antopoid/Projet-frelons/Rapports_seances/kevin_DELLAPIAZZA.md

1er semestre

Séance du 27/08/21

-Récupération du dossier Git du groupe de l'année précédente
-Lecture et prise en main de l'ancien projet
-Visite des ruches sur le site polytech pour comprendre la problématique 
-récupération du matériel + définition des tâches à réaliser

Séance du 09/09/21

-Test des capteurs de tonalité sur site polytech au niveau des ruches
-Résultat pas concluant, Avec un enregistrement le module déclenche bien la présence d'un frelon 
mais lorsque l'on test en réel le module ne déclenche pas
-Nous supposons que le signal en entrée est trop faible par conséquent il va falloir les amplifier
-Vu que nous avons deux modules de détection:
	* sur la première, changement R2 470->220 Ohms pour augmenter le gain
	* sur la deuxième, changement du micro par un micro qui a un diamètre plus grand
	* sur les deux, changement des condensateurs C1 1µF -> 47µF 

Séance du 17/09/21

-Call fait avec Bernard Barrois et Jody Nourry sur le projet depuis longtemps afin de nous exposer 
leur problématique + explication du projet.
-Recherche des fréquences de détection (proche des 230Hz) rapport de test.
-Décision de mettre en suspent le détecteru de tonalité afin de créer une carte avec un esp32WROVER

Séance du 23/09/21

-Travaille de recherche sur les I/O et définitions de celles-ci (disponible ou non)
-Call sur un projet de détection d'image 

2ème semestre

Séance du 03/02/2022 

Recherche dans les datasheets afin de trouver et/ou de calculer les différentes consommations des sorties. 
Caméra : En action : 125mW 
	 En standby : P = U*I; Avec U=3.3V et I= 600µA Soit P= 3.3 * 600 E-6 = 1980 * 10-6

Séance du 10/02/2022 et du 11/02/2022

Objectif de la séance: faire fonctionner les différents systèmes
		       analyser le code pour la caméra (cf mail peter 06/02/2022)
Durant ces séances: analyse des différentes sources données dans le mail, j'ai essayé de comprendre les codes ce qui n'a pas était facile pour certains codes.

Séance du 03/03/2022 et du 04/03/2022

Objectif de la séance: analyser le code pour la caméra (cf mail peter 06/02/2022)
suite aux recherches faite les séances précédentes, je e suis attardé au répertoires du git données dans le mail avec le code pour la caméra:
Detecteur-ESP32-Cam-Blob-Detector/sketchbook/CaptureWithoutDelay_save3_6/CaptureWithoutDelay_save3_6.ino 
Dans un premier temps j'ai analysé l'ensemble du code afin de le comprendre et de savoir ce qui était fait.
puis dans un second temps, j'ai regardé fonction par fonction afin de les analyser une par une.
Le code permet de capturer les images issue de la caméra, dans le même temps de les analyser afin de voir les points les plus noirs sur la photo et de réagir en conséquence. 
une fois que les cliché ont était analyser selon la position de la tâche nous allons placer le laser afin de pointer l'endroit de l'image et d'actionner le laser. 

Séance du 11/03/2022
Présentation de la partie code caméra
Note suite à la présentation: rapport écrit pour la réalisation du code à transemettre au groupe
Continue les analyses du code et recherche sur les autres déposit fournie par Barrois

Séance du 29/03/2022

Objectif de la séance : rédaction du document descriptif de l'analyse des codes 

Le document, une fois finalisé, sera posté dans le fichier kevin_DELLAPIAZZA.

Durant cette séance j'ai également aidé pour testé la carte alimentation: 
	Nous avons dans un premier temps vérifier les 3V sur les PWM -> Validé
	Test V1: nous avons relevé 2.3 V pour 2.7 d'attendu
	Test V2: nous avons relevé 1.2V pour 1.8 attendu
