antopoid/Projet-frelons/Présentation_soutenance.pptx

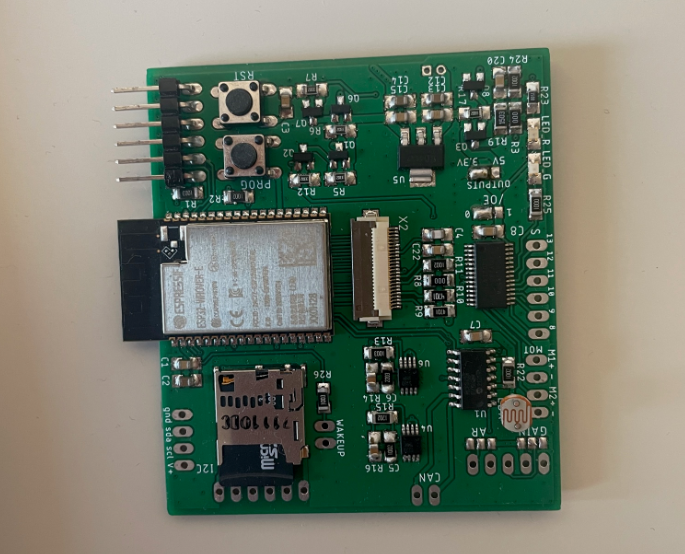
[picture p3: figure]

Projet Frelon
Soutenance finale

Lavenne, Kagbadouno, Delaunay, Poidevin, Dellapiazza

## Sommaire

- Rappel du projet
- Planning
- Test effectué sur la carte de test
- Test des fonctionnalités du PCBA
- La suite?

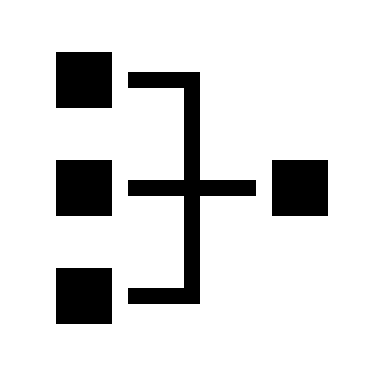
[picture p4: figure]
Schéma de réseau avec un remplissage uni

## Rappel du projet

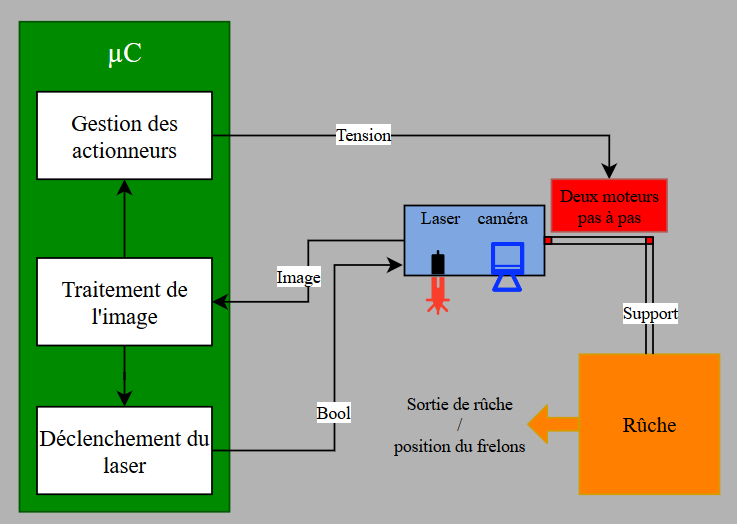
[picture p5: figure]

- Concevoir un système autonome pouvant protéger une ruche des frelons
- Utiliser un ESP32
- Trouver un moyen d’utiliser tous les périphériques malgré la contrainte sur les I/O

## Planning

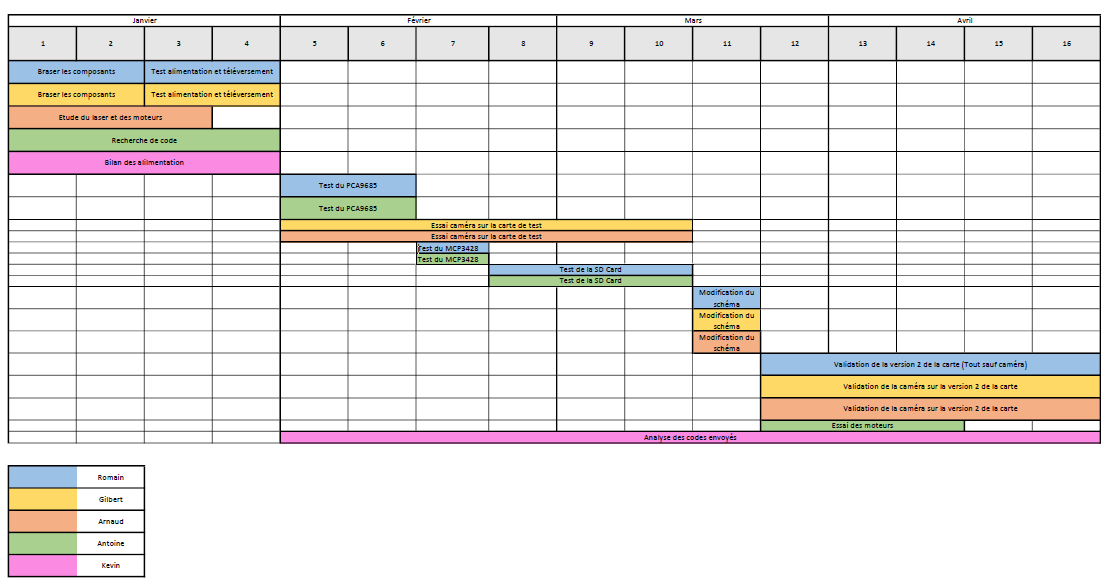
[picture p6: figure]

## Carte de test

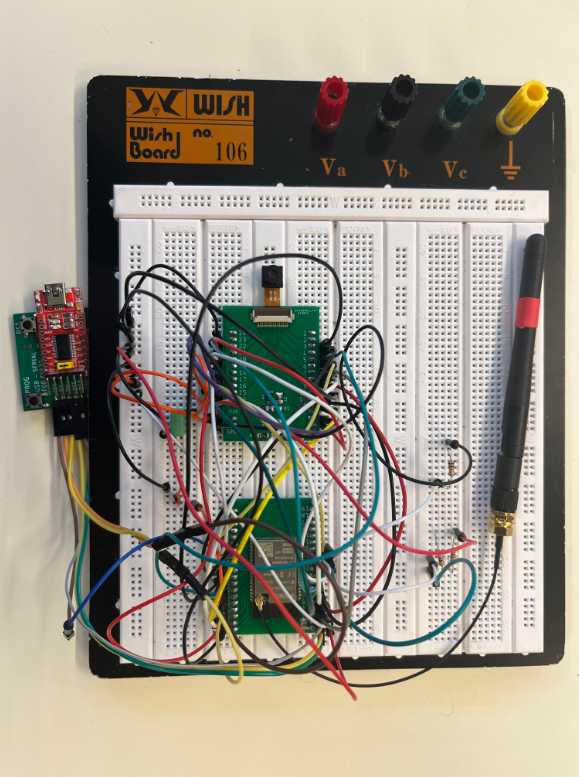
[picture p7: figure]

Carte de report caméra

Carte de report ESP32

- Vérifier les mêmes fonctionnalités en parallèle des essais sur le PCBA
- Faciliter le debug
- Trouver les anomalies
- Corriger et adapter le schéma final

## Carte de test

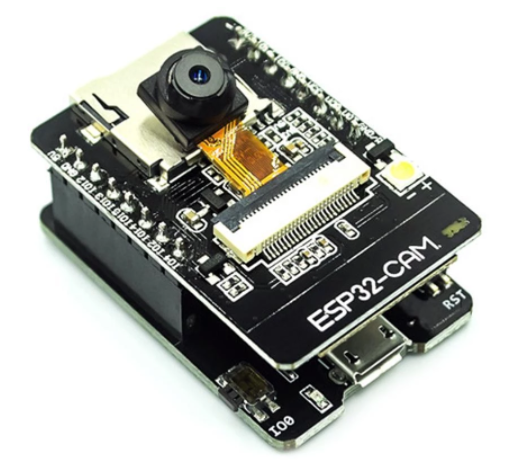
[picture p8: figure]

- Premiers essais sur un ESP32 CAM
- Valider un premier programme permettant de faire fonctioner la caméra

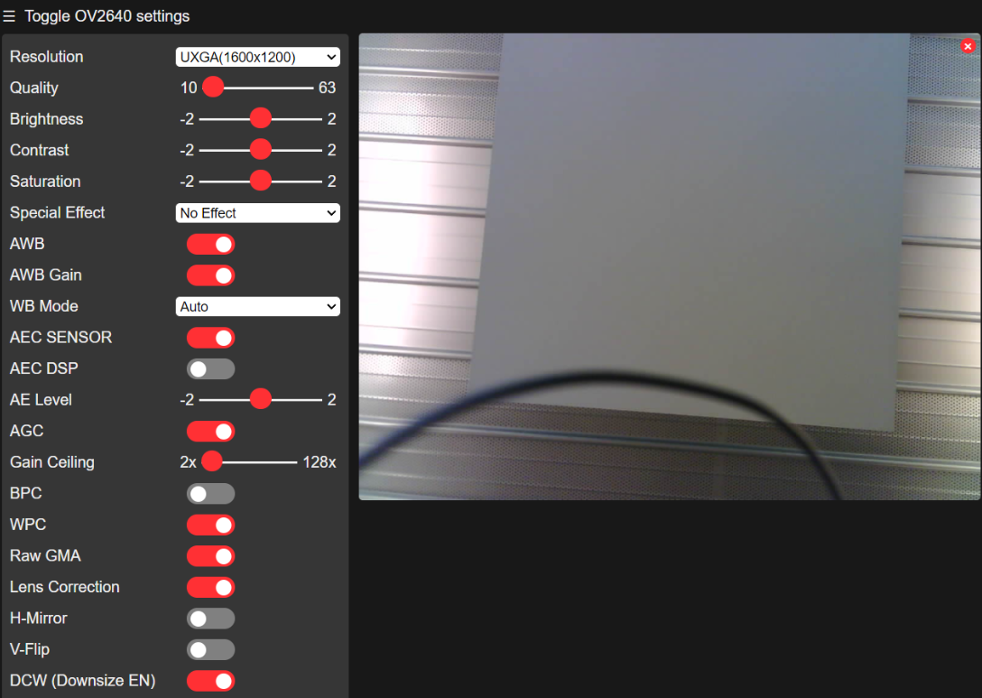
[picture p9: figure]

## Carte de test

Carte de report caméra

Carte de report ESP32

- Réutiliser le même code sur la carte de test
- Vérifier et adapter la correspondance des I/O
- Mesure des différents signaux d’alimentations

## Carte de test

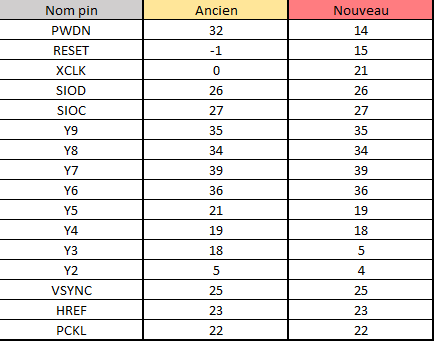
[picture p10: figure]

- Adaptation des pins

## Carte de test

Avant

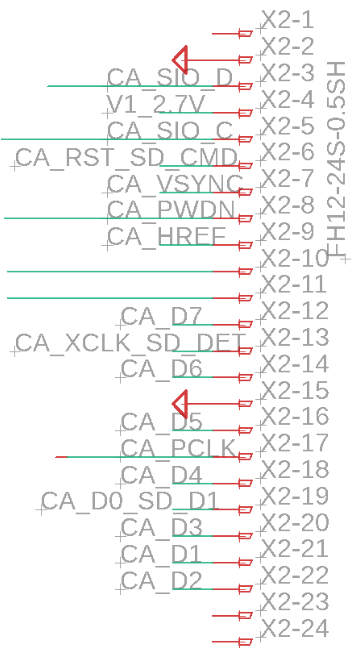
[picture p11: figure]

Après

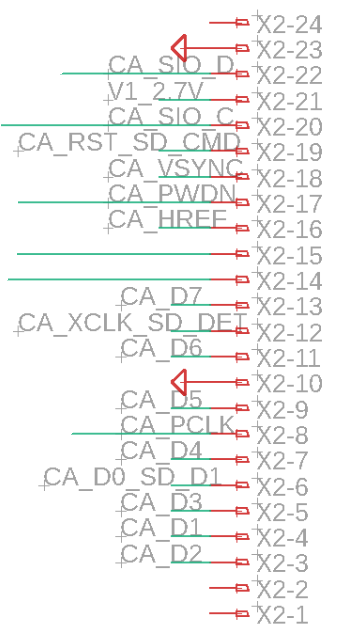
[picture p12: figure]

- Correspondance entre les pins et le bornier incorrect

## Test des fonctionnalités du PCBA

Micro

LDR

MCP3428

I2C

ESP32

I/O Caméra

Caméra

Spare

I/O Communes

Laser

PCA9685

SD Card

Alimentations

Moteurs

I/O SD Card

Leds

## Schéma du PCBA

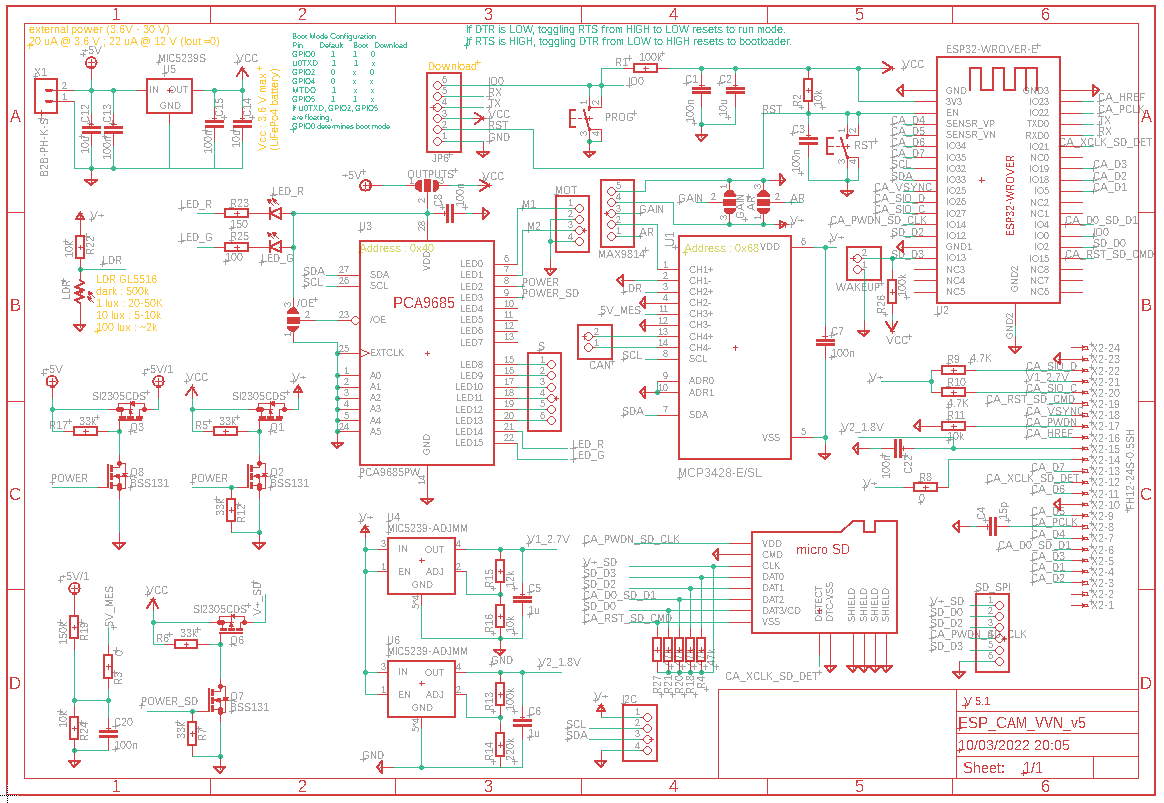
[picture p13: figure]

## Routage

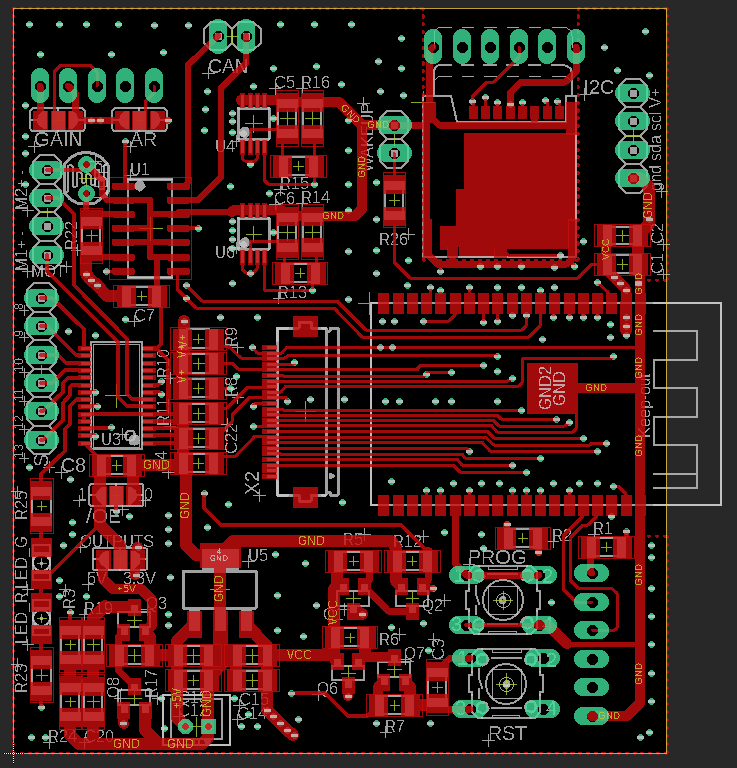
[picture p14: figure]
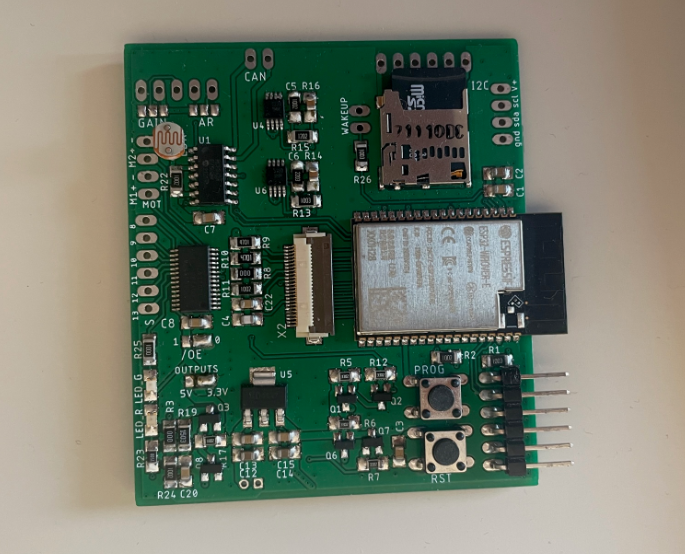
[picture p15: figure]

## Déroulement des tests

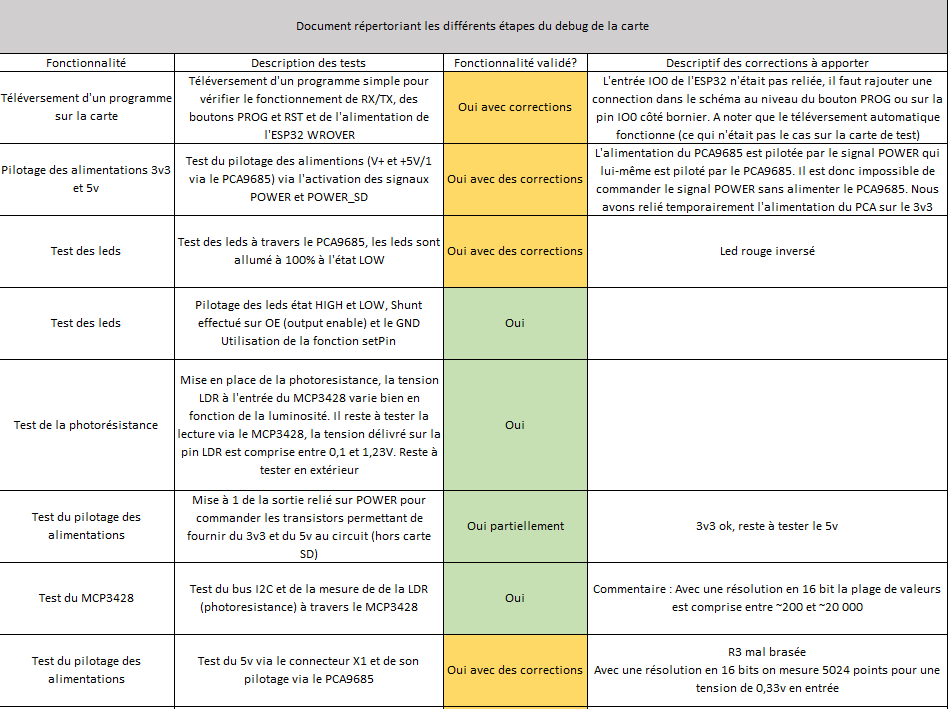
[picture p16: figure]

- Création d’un fichier de suivi
- Faciliter le debug de la carte et l’apport des corrections

## Alimentations et communication

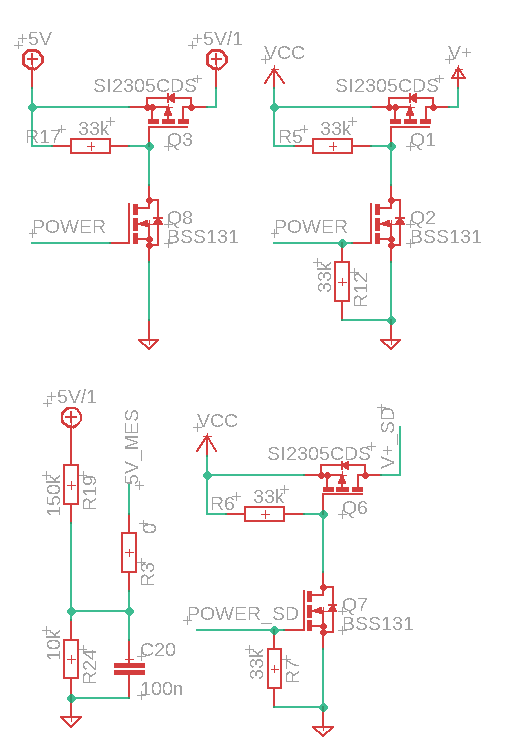
[picture p17: figure]

- I0 non connecté
- PCA9685 non alimenté en direct
- Pins I2C non standard

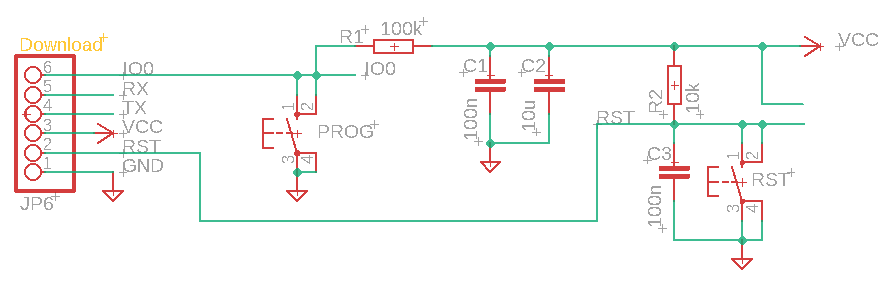
[picture p18: figure]

## PCA9685

Laser

Moteurs

Alimentations

PCA9685

Leds

- Test du pilotage des alimentations
- Faire clignoter simultanément les leds
- Faire tourner un moteur

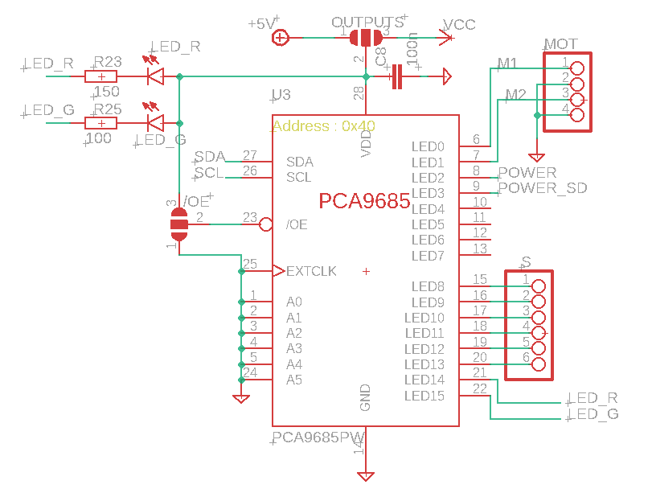
[picture p19: figure]

## MCP3428

Micro

LDR

Spare

MCP3428

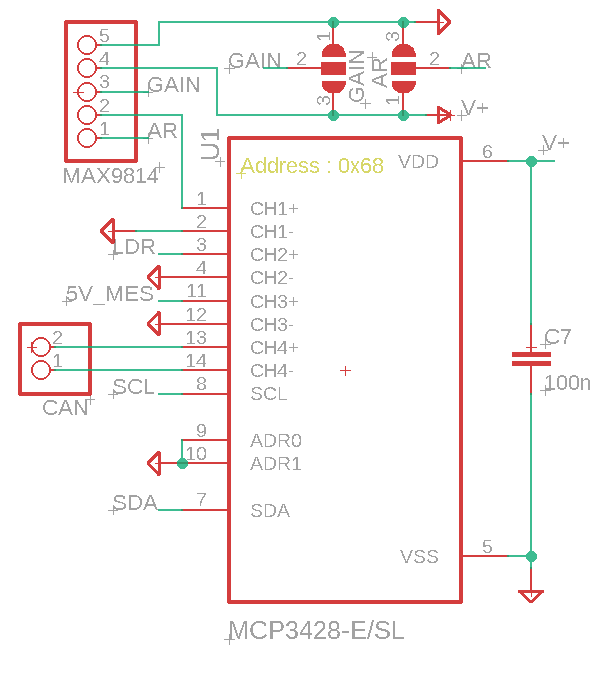
[picture p20: figure]

- Test de lecture de la valeur de la LDR sur 16 bits
- 0,1V - 1,23V ou 200 – 200 000 points
- Test de la mesure du 5V
- 0,33V – 5024 points

## SD Card

SD Card

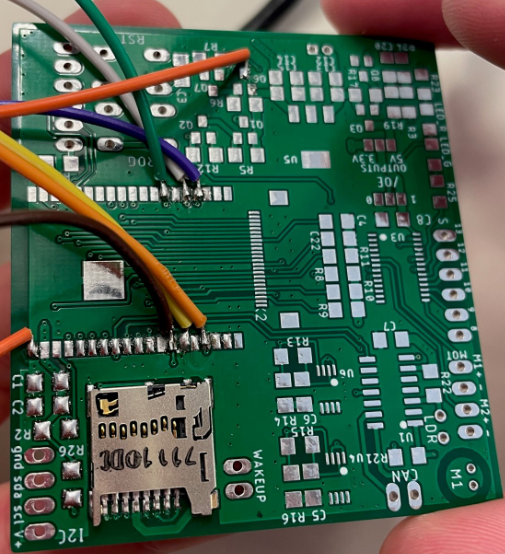
[picture p21: figure]

- Pins inversés
- Essai avec une carte de test et un ESP32 Lora concluant
- Test sur la version 2 de la carte, creation d’un fichier et d’un dossier

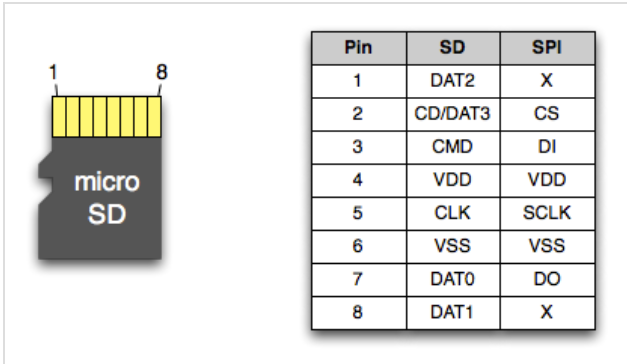
[picture p22: figure]

## Caméra

Caméra

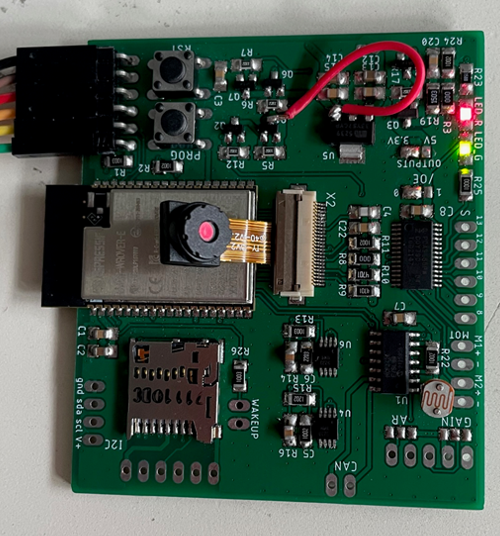
[picture p23: figure]

- Sérigraphie erronée
- Inversion C5/R16 et C6/R14
- Tensions pour la caméra correctes (1.8V, 2.7V, 3,3V)
- Caméra fonctionnelle (shunt alimentation)

## Analyse code Caméra

Caméra

Tirer avec le laser

Laser zone image

Réduction

Analyser cliché

Trouver frelon

Prendre cliché

Enregistrer cliché

## Bilan

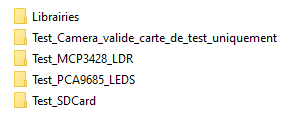
[picture p24: figure]

Programmes de test sur git

PCA9685

MCP3428

SD Card

Caméra

- Validé, verifier la partie pilotage des alimentations sur les nouveaux PCB

Validé, mais micro non testé

Validé, mais semble non fonctionnel avec une alimentation par USB

Validé
