antopoid/Projet-frelons/Dossier Antoine/Présentation Perso.pptx

## Présentation Personnelle Projet de ruche connectée

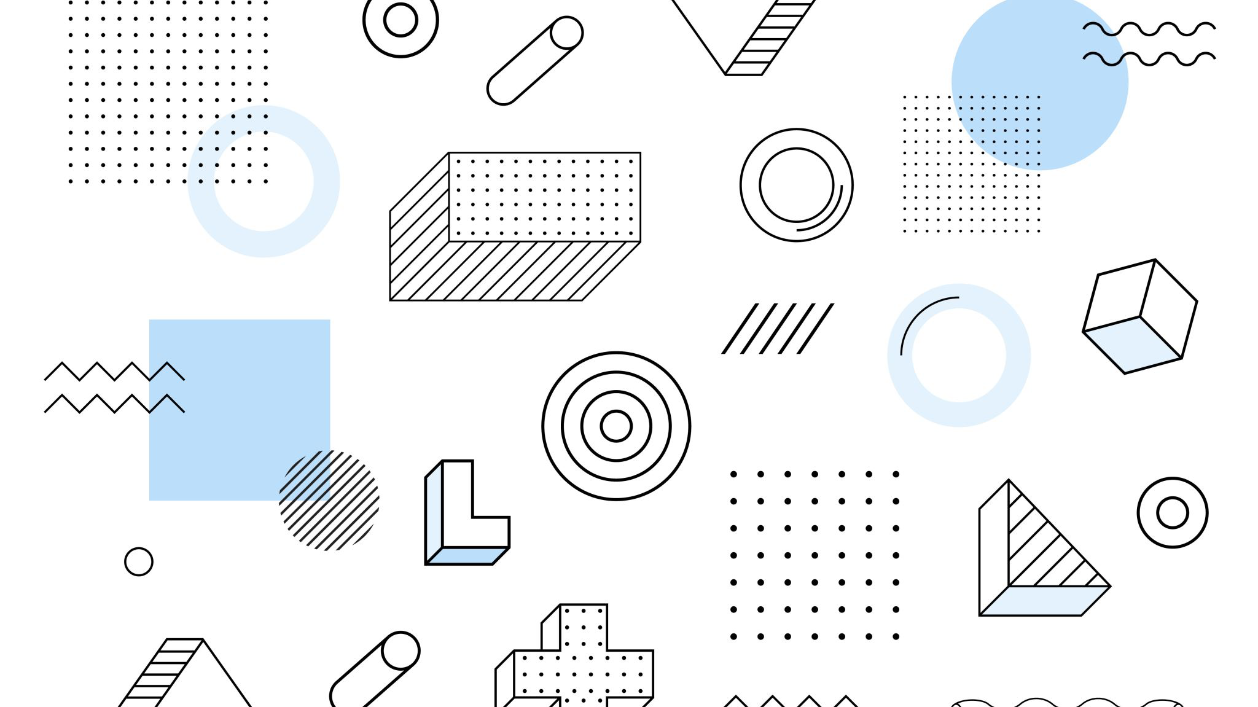
[picture p25: figure]
Représentation vectorielle moderne avec l’élément bleu

Antoine Poidevin
EII4
Polytech Nice Sophia

## Bref résumé des taches effectuées

- Création du git et explication au groupe
- Enregistrement et analyse du son des frelons
- Etudes du programmes de l’esp32-cam
- Test de l’esp32 soudé sur la carte de test
- Recherche de librairies adéquates pour notre montage
- Création d’un code fonctionnel
- Soudure, débogage, brasage, câblage.

## Création du git et explication au groupe

- https://github.com/antopoid/Projet-frelons
- Explications basiques sur le fonctionnement conventionnel de GIT
- Explications sur les commandes GIT à utiliser
- Création du GIT
- Création des répertoires et fichier de base sur le GIT

## Enregistrement et analyse du son des frelons

- Enregistrement de différents sons de frelons à cotés des ruches avec le groupe
- Analyse du son sur Audacity et décorticage du spectre en fréquence
- Test non concluant sur les différentes cartes

## Etudes du programmes de l’esp32-cam

- L’esp32-Cam de cher AiThinker possède une librairie dédié et un code servant d’exemple
- https:// (https://github.com/espressif/arduino-esp32/blob/master/libraries/ESP32/examples/Camera/CameraWebServer/CameraWebServer.ino)github.com (https://github.com/espressif/arduino-esp32/blob/master/libraries/ESP32/examples/Camera/CameraWebServer/CameraWebServer.ino)/ (https://github.com/espressif/arduino-esp32/blob/master/libraries/ESP32/examples/Camera/CameraWebServer/CameraWebServer.ino)espressif (https://github.com/espressif/arduino-esp32/blob/master/libraries/ESP32/examples/Camera/CameraWebServer/CameraWebServer.ino)/arduino-esp32/blob/master/ (https://github.com/espressif/arduino-esp32/blob/master/libraries/ESP32/examples/Camera/CameraWebServer/CameraWebServer.ino)libraries (https://github.com/espressif/arduino-esp32/blob/master/libraries/ESP32/examples/Camera/CameraWebServer/CameraWebServer.ino)/ESP32/ (https://github.com/espressif/arduino-esp32/blob/master/libraries/ESP32/examples/Camera/CameraWebServer/CameraWebServer.ino)examples (https://github.com/espressif/arduino-esp32/blob/master/libraries/ESP32/examples/Camera/CameraWebServer/CameraWebServer.ino)/Camera/ (https://github.com/espressif/arduino-esp32/blob/master/libraries/ESP32/examples/Camera/CameraWebServer/CameraWebServer.ino)CameraWebServer (https://github.com/espressif/arduino-esp32/blob/master/libraries/ESP32/examples/Camera/CameraWebServer/CameraWebServer.ino)/ (https://github.com/espressif/arduino-esp32/blob/master/libraries/ESP32/examples/Camera/CameraWebServer/CameraWebServer.ino)CameraWebServer.ino (https://github.com/espressif/arduino-esp32/blob/master/libraries/ESP32/examples/Camera/CameraWebServer/CameraWebServer.ino)
- C’est un serveur web connecté en wifi faisant un Stream vidéo de la camera embarqué
- L’image est traitée et analysée par l’appareil se connectant sur la page web local
- Apres avoir étudié ce code il nous servira par la suite pour tester

## Test de l’esp32 soudé sur la carte de test

- Brasage de l’esp32 dans un four avec le groupe
- Branchement de l’esp32 avec le petit module USB-serie
- Vérification des tensions obtenues
- Création d’un code basique ou l’on communique avec le port série
- Teléversement et validation du fonctionnement

## Recherche de librairies adéquates pour notre montage

- Il nous fallait des librairies pour tester le fonctionnement du :
- PCA9685
- MCP3428
- Camera
- Carte SD
Recherche de librairies bien spécifique permettant de changer les ports dédié au fonctionnement de chaque modules

## Création d’un code fonctionnel
