antopoid/Projet-frelons/Tuto-ESP32Cam.pdf

# C'est quoi une ESP32-Cam ?Comment la programmer ?

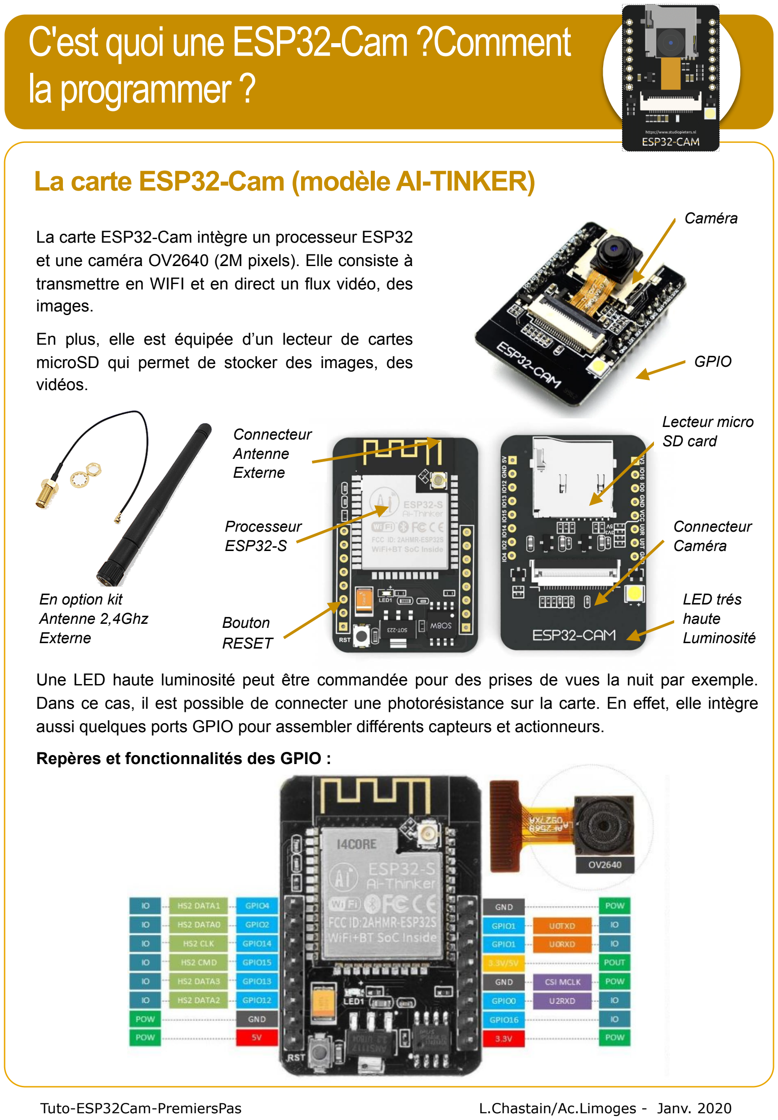
[picture p26: page 1]

Tuto-ESP32Cam-PremiersPas | L.Chastain/Ac.Limoges - Janv. 2020

La carte ESP32-Cam intègre un processeur ESP32 et une caméra OV2640 (2M pixels). Elle consiste à transmettre en WIFI et en direct un flux vidéo, des images.

En plus, elle est équipée d’un lecteur de cartes microSD qui permet de stocker des images, des vidéos.

## La carte ESP32-Cam (modèle AI-TINKER)

Caméra

Connecteur
Antenne
Externe

En option kit
Antenne 2,4Ghz
Externe

Processeur
ESP32-S

Bouton
RESET

Lecteur micro
SD card

Connecteur
Caméra

LED trés
haute
Luminosité

Une LED haute luminosité peut être commandée pour des prises de vues la nuit par exemple. Dans ce cas, il est possible de connecter une photorésistance sur la carte. En effet, elle intègre aussi quelques ports GPIO pour assembler différents capteurs et actionneurs.
Repères et fonctionnalités des GPIO :

GPIO

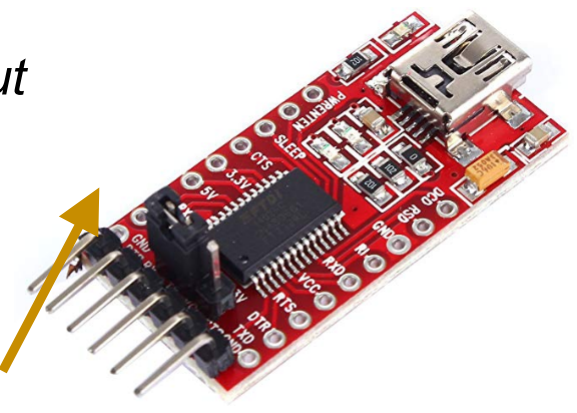
[picture p27: figure]
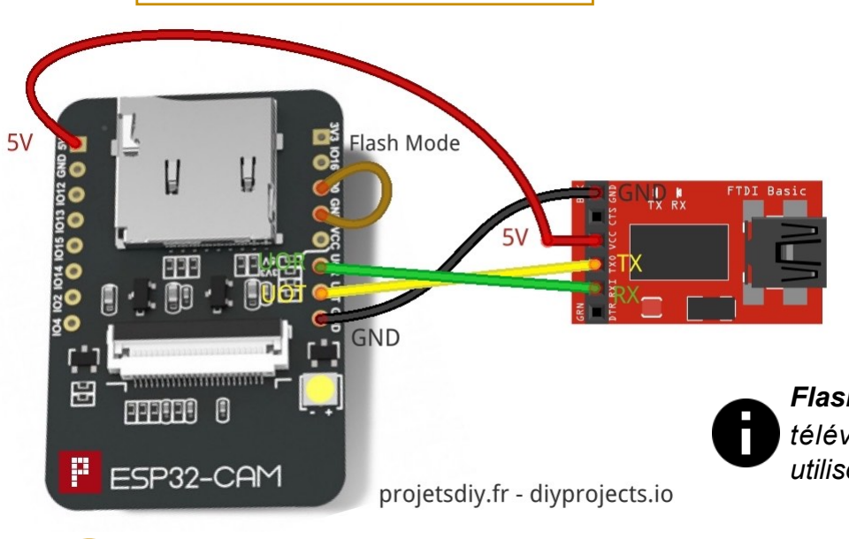
[picture p28: figure]
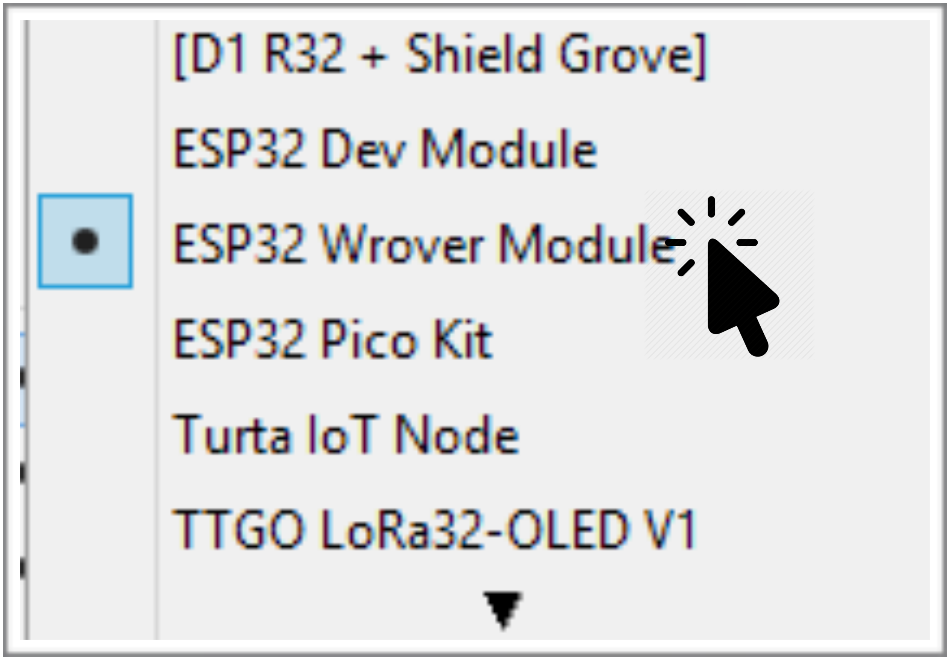
[picture p29: figure]

Tuto-ESP32Cam-PremiersPas | L.Chastain/Ac.Limoges - Janv. 2020

Il s’agit de charger le serveur vidéo web dans la carte. Le programme est mis à disposition dans la version d’Arduino Augmenté de chez DUINOEDU qui intègre la bibliothèque adéquate.

Réaliser le câblage et
connecter le FTDI au PC

1

## Programmer la carte ESP32-Cam(AI-Tinker)

Pour téléverser tout programme dans la carte ESP32-Cam, il faut utiliser un module électronique appelé FTDI232.

Cavalier sur 5V

ESP32Cam | FTDI
GND | GND
5V | VCC
U0R | TX
U0T | RX
GPIO0 | GND

Flash Mode : relier GPI0 au GND lors du téléversement. Retirer le câble pour utiliser la ESP32cam.

Lancer l'IDE Arduino
Augmenté

2

Aller dans Outils-->Gestionnaire de c a r t e s - - > S é l e c t i o n n e r ESP32WroverModule

3

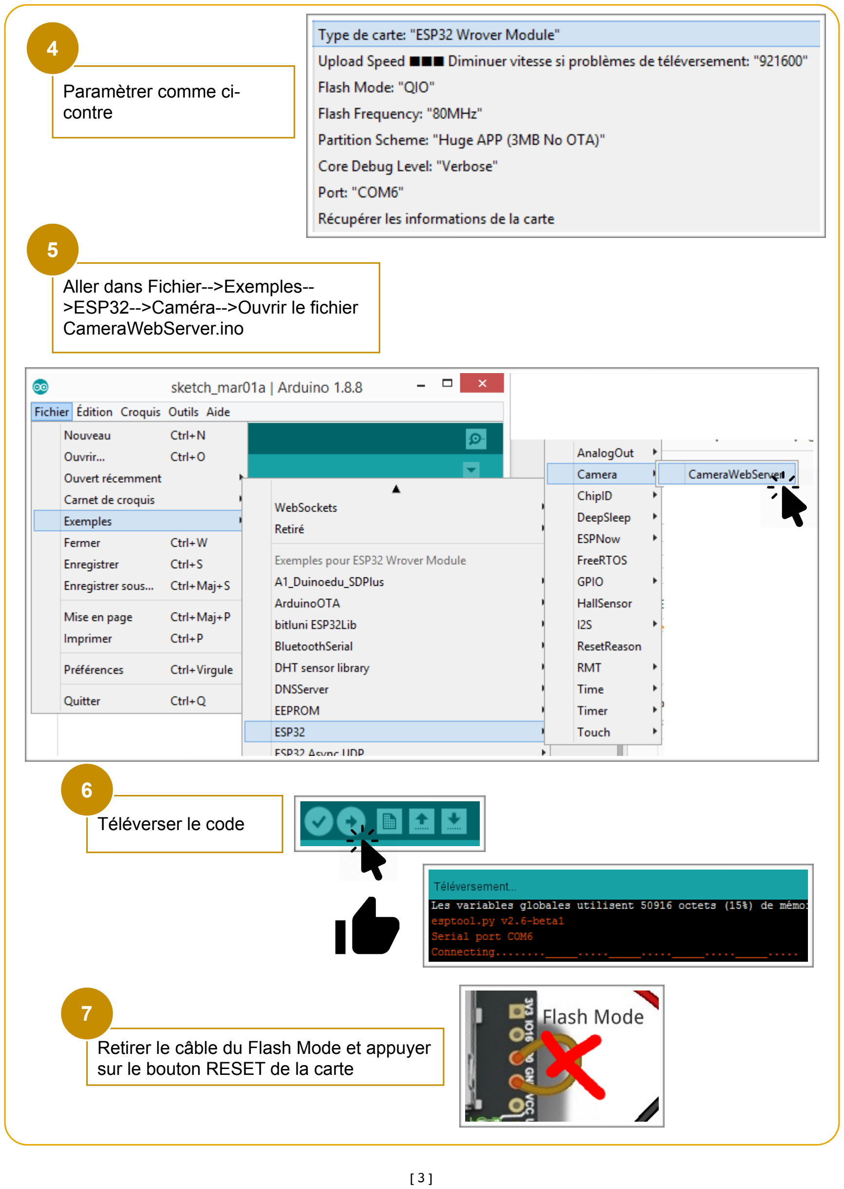
[picture p30: page 3]

[3]

Aller dans Fichier-->Exemples-->ESP32-->Caméra-->Ouvrir le fichier CameraWebServer.ino

5

Paramètrer comme ci-contre

4

Téléverser le code

6

Retirer le câble du Flash Mode et appuyer sur le bouton RESET de la carte

7

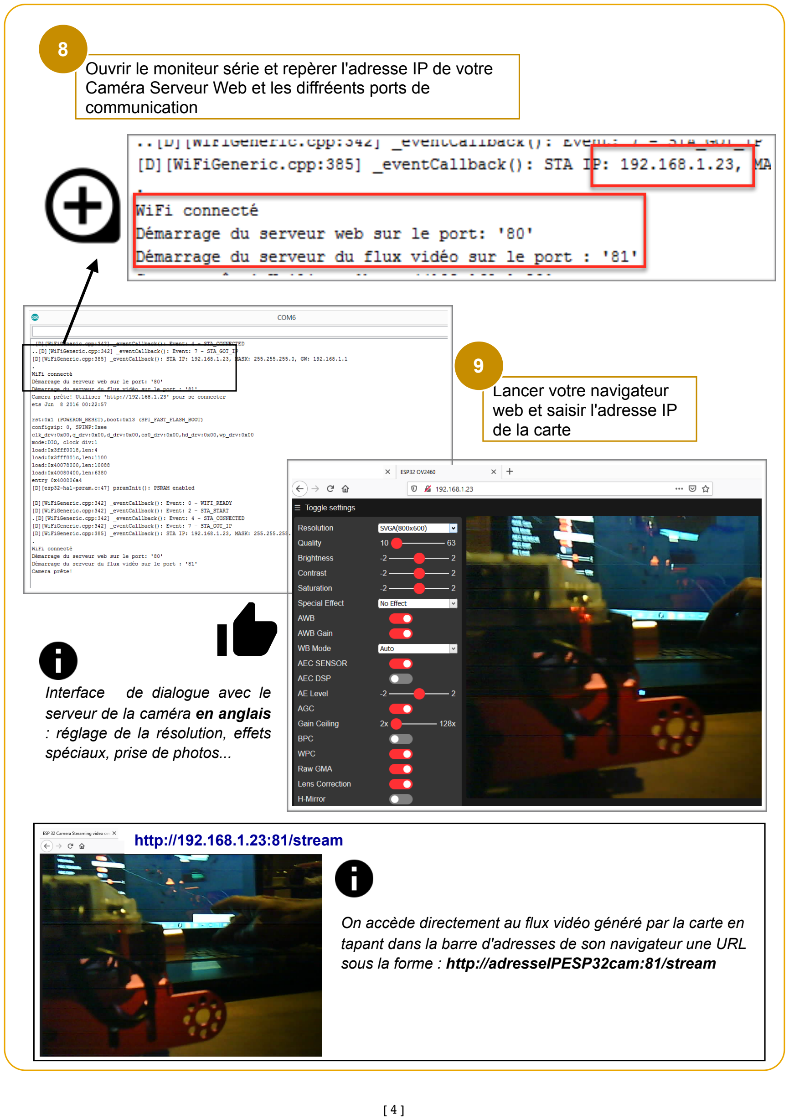
[picture p31: page 4]

[4]

Ouvrir le moniteur série et repèrer l'adresse IP de votre Caméra Serveur Web et les diffréents ports de communication

8

Lancer votre navigateur
web et saisir l'adresse IP de la carte

9

Interface de dialogue avec le serveur de la caméra en anglais : réglage de la résolution, effets spéciaux, prise de photos...

On accède directement au flux vidéo généré par la carte en tapant dans la barre d'adresses de son navigateur une URL sous la forme : http://adresseIPESP32cam:81/streamhttp://192.168.1.23:81/stream
