antopoid/Projet-frelons/Gantt.pdf

Test du MCP3428
Test du MCP3428

Modification du
schéma
| Modification du schéma
| | Validation de la version 2 de la carte (Tout sauf caméra)
| | Validation de la caméra sur la version 2 de la carte
| | Validation de la caméra sur la version 2 de la carte
| | Essai des moteurs
Analyse des codes envoyés

Romain

Gilbert

Arnaud

Antoine

Kevin

Test de la SD Card
Test de la SD Card
| Modification du schéma

Essai caméra sur la carte de test

Janvier | Février | Mars | Avril
1 | 2 | 3 | 4 | 5 | 6 | 7 | 8 | 9 | 10 | 11 | 12 | 13 | 14 | 15 | 16
Braser les composants | | Test alimentation et téléversement
Braser les composants | | Test alimentation et téléversement

Etude du laser et des moteurs

Recherche de code

Bilan des alilmentation

| | | | Test du PCA9685
| | | | Test du PCA9685
| | | | Essai caméra sur la carte de test

#Internal
