antopoid/Projet-frelons/Dossier Romain/1.jpg

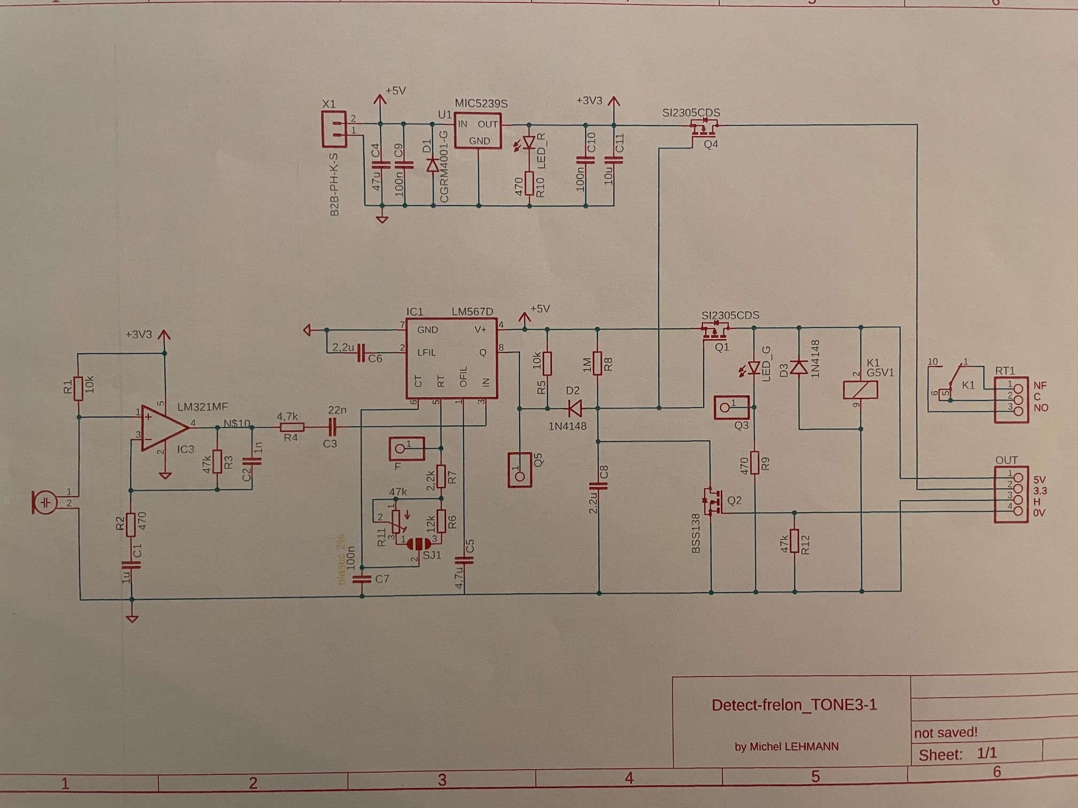
Dossier Romain/1.jpg
