antopoid/Projet-frelons/Dossier Romain/2.jpg

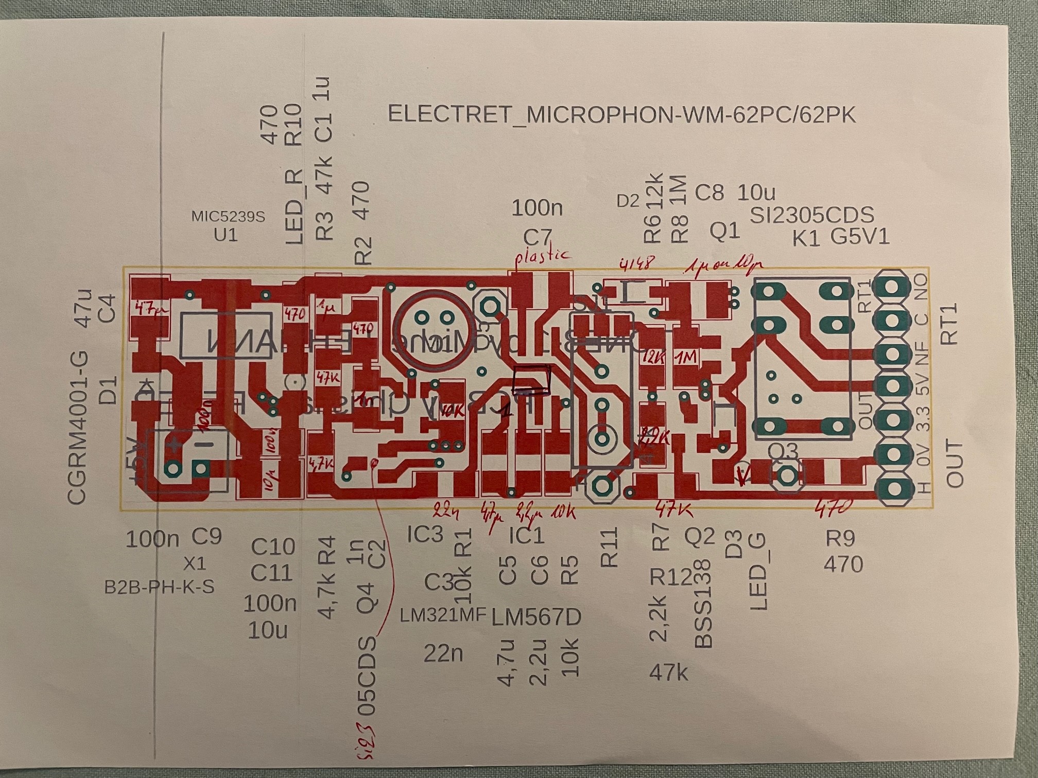
Dossier Romain/2.jpg
