antopoid/Projet-frelons/Ancien Projet/Rapport de fabrication/READ ME.md

## Bzz_final : 
projet arduino à téleverser sur l'ESP32-CAM.

  A faire : 
*    Réception message de détection sonore d'un frelon par l'Arduino (UART)
*    Tests

## fft_detection : 
projet arduino à téleverser sur l'Arduino Micro.
  
  A faire : 
*    Envoi du message de détection sonore d'un frelon par L'Arduino (UART)

## calculateur_composant_buck : 
Calcule les valeurs des composants utilisés pour le circuit qui pilote le laser

## Ruche_V1.0
Cartes électroniques sous Kicad ainsi que les bibliothèques des composants nécessaires.

  A faire :
*    Ajouter la photorésistance
*    Ajouter le régulateur Boost +12V
*    Faire la BOM (Bills Of Materials)
*    Rooter le PCB (Printed Circuit Board)
