antopoid/Projet-frelons/(list of files, drawings)

Other design files:
ExecutablePourTest/Librairies/MFRC522/doc/fritzing/Arduino-Uno-r3-with-RFID-RC522.fzz
