antopoid/Projet-frelons/Ancien Projet/Dossier Lucas/Ruche_V1.0/Projet_ruche_V1.0/Projet_ruche_V1.0.kicad_pcb

## KiCad design PRO-BOX.kicad_sch

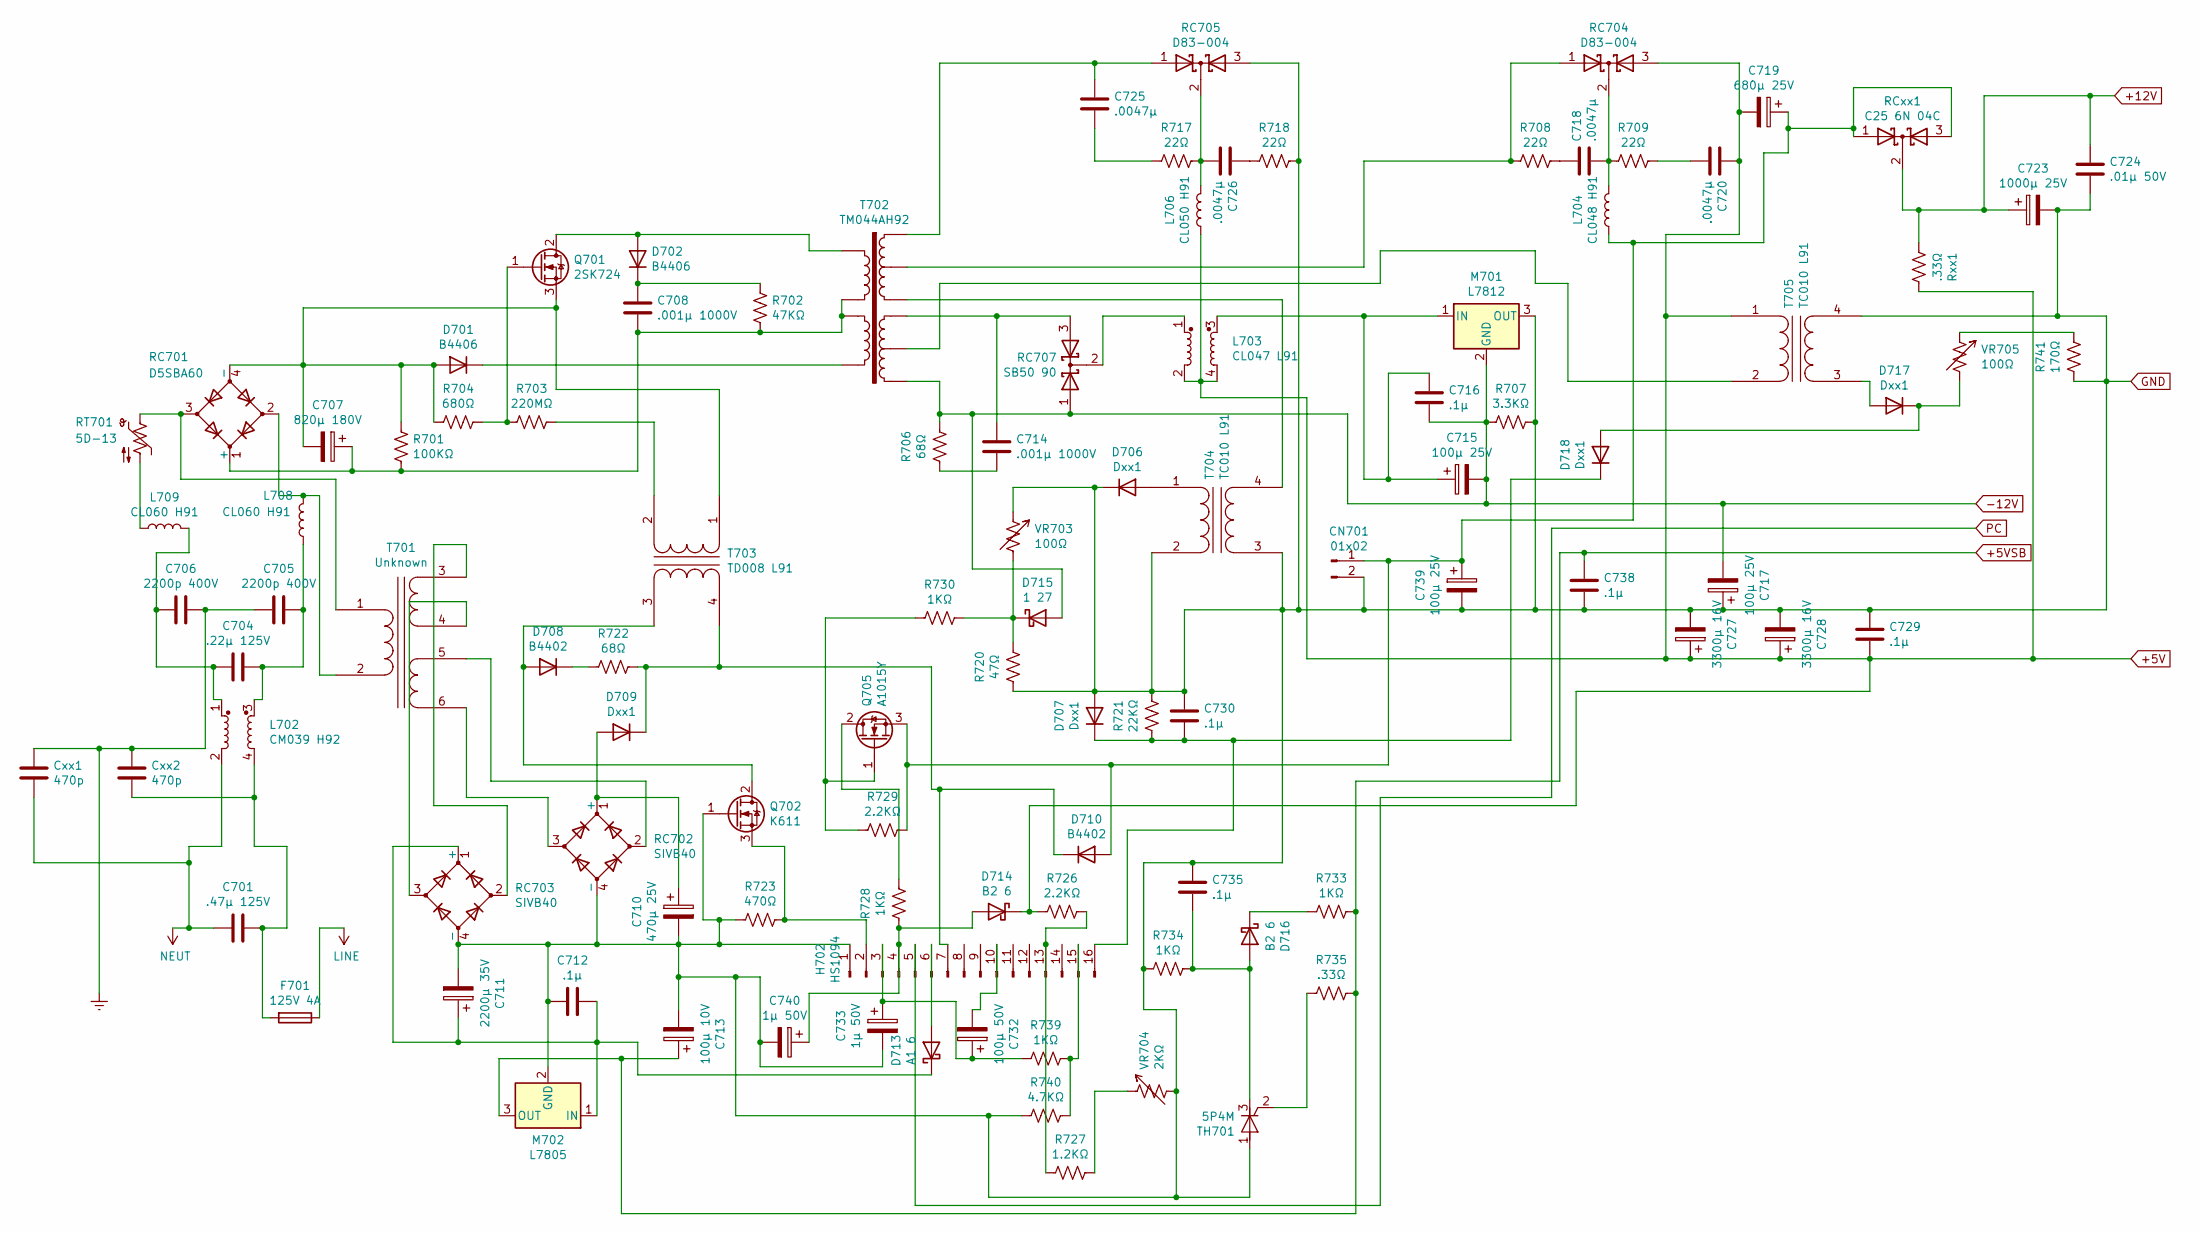
[picture p81: schematic PRO-BOX.kicad_sch]

Parts:
C701: .47μ 125V
C704: .22μ 125V
C705, C706: 2200p 400V
C707: 820μ 180V
C708, C714: .001μ 1000V
C710: 470μ 25V
C711: 2200μ 35V
C712, C716, C729, C730, C735, C738: .1μ
C713: 100μ 10V
C715, C717, C739: 100μ 25V
C718, C720, C725, C726: .0047μ
C719: 680μ 25V
C723: 1000μ 25V
C724: .01μ 50V
C727, C728: 3300μ 16V
C732: 100μ 50V
C733, C740: 1μ 50V
CN701: 01x02
Cxx1, Cxx2: 470p
D701, D702: B4406
D706, D707, D709, D717, D718: Dxx1
D708, D710: B4402
D713: A1 6
D714, D716: B2 6
D715: 1 27
F701: 125V 4A
H702: HS1094
L702: CM039 H92
L703: CL047 L91
L704: CL048 H91
L706: CL050 H91
L708, L709: CL060 H91
M701: L7812
M702: L7805
Q701: 2SK724; TO-220-3_Vertical
Q702: K611; TO-220-3_Vertical
Q705: A1015Y; TO-220-3_Vertical
R701: 100KΩ
R702: 47KΩ
R703: 220MΩ
R704: 680Ω
R706, R722: 68Ω
R707: 3.3KΩ
R708, R709, R717, R718: 22Ω
R720: 47Ω
R721: 22KΩ
R723: 470Ω
R726, R729: 2.2KΩ
R727: 1.2KΩ
R728, R730, R733, R734, R739: 1KΩ
R735: .33Ω
R740: 4.7KΩ
R741: 170Ω
RC701: D5SBA60
RC702, RC703: SIVB40
RC704, RC705: D83-004
RC707: SB50 90
RCxx1: C25 6N 04C
RT701: 5D-13
Rxx1: .33Ω
T701: Unknown
T702: TM044AH92
T703: TD008 L91
T704, T705: TC010 L91
TH701: 5P4M; TO-92_Inline
VR703, VR705: 100Ω
VR704: 2KΩ

Connections:
+5V: C719.2, C720.1, C727.1, C728.1, C729.2, D714.1 (K), L703.2, L703.4, L706.1, R726.1, RC704.3 (A), Rxx1.2, T705.1 (AA)
+5VSB: C713.1, C738.1, M702.3 (OUT), R733.2, R735.2
+12V: C723.1, C724.1, RCxx1.2 (K), Rxx1.1
-12V: C715.2, C716.2, C717.2, D715.2 (A), M701.2 (GND), R706.2, R707.1, RC707.1 (A), T702.5
GND: C710.2, C711.2, C712.2, C713.2, C717.1, C723.2, C724.2, C727.2, C728.2, C729.1, C730.1, C733.2, C735.1, C738.2, C739.2, C740.2, CN701.2, D706.1 (K), D707.2 (A), H702.1, M701.3 (OUT), M702.2 (GND), Q702.1 (G), R707.2, R718.2, R720.1, R721.2, R723.1, R734.1, R740.1, R741.1, RC702.4 (-), RC703.4 (-), RC705.3 (A), T704.2 (AB), T704.3 (SA), T705.4 (SB), TH701.1 (A), VR703.1, VR704.2
unnamed: C701.1, Cxx2.2, F701.2, L702.4
unnamed: C701.2, Cxx1.2, L702.2
unnamed: C704.1, C705.1, L702.3, L708.2
unnamed: C704.2, C706.2, L702.1, L709.2
unnamed: C705.2, C706.1, Cxx1.1, Cxx2.1
unnamed: C707.1, C708.2, R701.2, R702.2, RC701.1 (+), T702.2, T702.3
unnamed: C707.2, D701.2 (A), Q701.3 (S), R701.1, R704.2, RC701.4 (-), T703.1 (AA)
unnamed: C708.1, D702.1 (K), R702.1
unnamed: C710.1, D709.2 (A), RC702.1 (+)
unnamed: C711.1, C712.1, D713.1 (K), M702.1 (IN), RC703.1 (+)
unnamed: C714.1, RC707.3 (A), T702.7
unnamed: C714.2, R706.1
unnamed: C715.1, C716.1, L703.3, M701.1 (IN)
unnamed: C718.1, R708.2
unnamed: C718.2, L704.2, R709.1, RC704.2 (K)
unnamed: C719.1, C739.1, CN701.1, D710.2 (A), L704.1, Q705.3 (S), R729.2, RCxx1.1 (A), RCxx1.3 (A)
unnamed: C720.2, R709.2
unnamed: C725.1, RC705.1 (A), T702.10
unnamed: C725.2, R717.1
unnamed: C726.1, R718.1
unnamed: C726.2, L706.2, R717.2, RC705.2 (K)
unnamed: C730.2, D707.1 (K), D718.1 (K), H702.16, R721.1
unnamed: C732.1, C733.1, H702.3, R739.1
unnamed: C732.2, H702.10
unnamed: C735.2, D716.2 (A), R734.2, TH701.3 (K)
unnamed: C740.1, D714.2 (A), H702.4, R728.1
unnamed: D701.1 (K), T702.4
unnamed: D702.2 (A), Q701.2 (D), T702.1
unnamed: D706.2 (A), T704.1 (AA)
unnamed: D708.1 (K), R722.1
unnamed: D708.2 (A), Q702.2 (D), T703.3 (SA)
unnamed: D709.1 (K), D710.1 (K), H702.7, R722.2, T703.4 (SB)
unnamed: D713.2 (A), H702.6
unnamed: D715.1 (K), R720.2, R730.2, VR703.2
unnamed: D716.1 (K), R733.1
unnamed: D717.1 (K), D718.2 (A), VR705.2
unnamed: D717.2 (A), T705.3 (SA)
unnamed: H702.2, Q702.3 (S), R723.2
unnamed: H702.13, R726.2, R727.1
unnamed: H702.15, R739.2, R740.2
unnamed: L703.1, RC707.2 (K)
unnamed: L708.1, RC701.2, T701.2 (AB)
unnamed: L709.1, RT701.2
unnamed: Q701.1 (G), R703.2, R704.1
unnamed: Q705.1 (G), R729.1, R730.1
unnamed: Q705.2 (D), R728.2
unnamed: R703.1, T703.2 (AB)
unnamed: R708.1, RC704.1 (A), T702.9
unnamed: R727.2, VR704.1
unnamed: R735.1, TH701.2 (G)
unnamed: R741.2, VR705.1
unnamed: RC701.3, RT701.1, T701.1 (AA)
unnamed: RC702.2, T701.5 (SC)
unnamed: RC702.3, T701.6 (SD)
unnamed: RC703.2, T701.3 (SA)
unnamed: RC703.3, T701.4 (SB)
unnamed: T702.6, T705.2 (AB)
unnamed: T702.8, T704.4 (SB)
PC: H702.5
