antopoid/Projet-frelons/Schema_carte/Essais/ESP_CAM_VVN_v4.brd

## EAGLE design Schema_carte/Essais/ESP_CAM_VVN_v4.brd (2022-03-04)

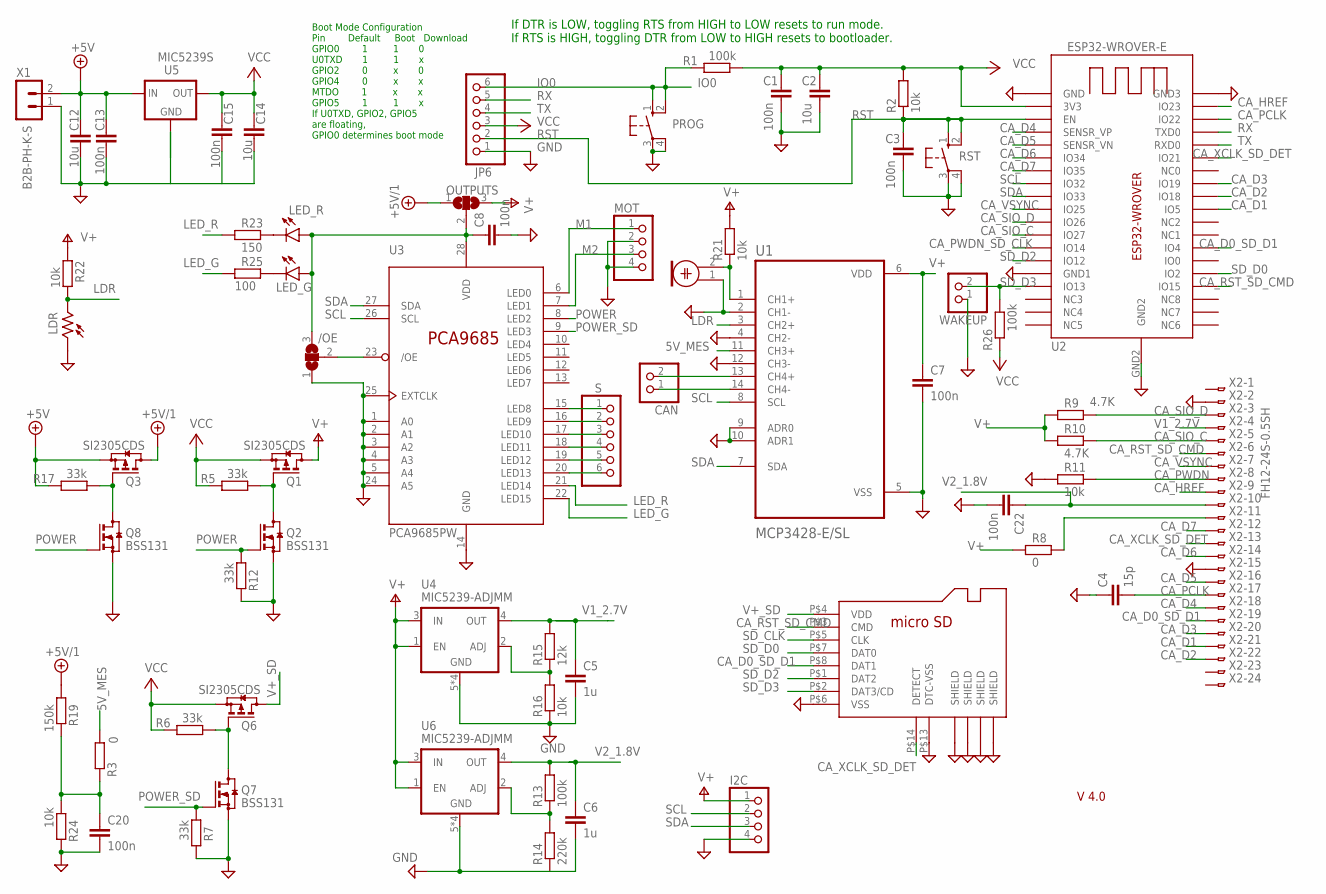
[picture p82: schematic ESP_CAM_VVN_v4.sch]

Parts:
/OE: SJ2W; SJ_2
C1, C3, C7, C8, C13, C15, C20, C22: 100n; C1206
C2, C12, C14: 10u; C1206
C4: 15p; C1206
C5, C6: 1u; C1206
CAN: PINHD-1X2; 1X02
I2C: PINHD-1X4; 1X04
JP6: PINHD-1X6/90; 1X06/90
LDR: VT93N2; VT900
LED_G: LEDSMT1206; 1206
LED_R: LEDSMT1206; 1206
M1: ELECTRET_MICROPHON-WM-62PC/62PK; WM-62PC/62PK
MOT: PINHD-1X4; 1X04
OUTPUTS: SJ2W; SJ_2
PROG: 10-XX; B3F-10XX
Q1, Q3, Q6: SI2305CDS; SOT23
Q2, Q7, Q8: BSS131; SOT23
R1, R13, R26: 100k; R1206
R2, R11, R16, R21, R22, R24: 10k; R1206
R3, R8: 0; R1206
R5, R6, R7, R12, R17: 33k; R1206
R9, R10: 4.7K; R1206
R14: 220k; R1206
R15: 12k; R1206
R19: 150k; R1206
R23: 150; R1206
R25: 100; R1206
RST: 10-XX; B3F-10XX
S: PINHD-1X6; 1X06
SD1: MICRO-SD-8; MICROSDMOLEX
U1: MCP3428-E/SL; SOIC127P600X175-14N
U2: ESP32-WROVER-E; ESP32-WROVER
U3: PCA9685PW; TSSOP28
U4, U6: MIC5239-ADJMM; MSOP08
U5: MIC5239S; SOT223
WAKEUP: PINHD-1X2; 1X02
X1: B2B-PH-K-S
X2: FH12-24S-0.5SH

Connections:
5V_MES: R3.1, U1.11 (CH3+)
+5V: C12.1, C13.1, Q3.2 (S), R17.2, U5.1 (IN), X1.2
+5V/1: OUTPUTS.1, Q3.3 (D), R19.1
CA_D0_SD_D1: SD1.P$8 (DAT1), U2.IO4, X2.19
CA_D1: U2.IO5, X2.21
CA_D2: U2.IO18, X2.22
CA_D3: U2.IO19, X2.20
CA_D4: U2.SENSOR_VP (SENSR_VP), X2.18
CA_D5: U2.SENSOR_VN (SENSR_VN), X2.16
CA_D6: U2.IO34, X2.14
CA_D7: U2.IO35, X2.12
CA_HREF: U2.IO23, X2.9
CA_PCLK: C4.2, U2.IO22, X2.17
CA_PWDN: R11.2, X2.8
CA_PWDN_SD_CLK: U2.IO14
CA_RST_SD_CMD: SD1.P$3 (CMD), U2.IO15, X2.6
CA_SIO_C: R10.2, U2.IO27, X2.5
CA_SIO_D: R9.2, U2.IO26, X2.3
CA_VSYNC: U2.IO25, X2.7
CA_XCLK_SD_DET: SD1.P$14 (DETECT), U2.IO21, X2.13
GND: /OE.1, C1.2, C2.2, C3.2, C4.1, C5.2, C6.2, C7.2, C8.2, C12.2, C13.2, C14.2, C15.2, C20.2, C22.2, I2C.4, JP6.1, LDR.1, M1.1, MOT.2, MOT.4, PROG.3, PROG.4 (P1), Q2.2 (S), Q7.2 (S), Q8.2 (S), R7.2, R11.1, R12.2, R14.1, R16.1, R24.2, RST.3, RST.4 (P1), SD1.P$6 (VSS), SD1.P$9 (SHIELD), SD1.P$10 (SHIELD), SD1.P$11 (SHIELD), SD1.P$12 (SHIELD), SD1.P$13 (DTC-VSS), U1.2 (CH1-), U1.4 (CH2-), U1.5 (VSS), U1.9 (ADR0), U1.10 (ADR1), U1.12 (CH3-), U2.GND, U2.GND1, U2.GND2, U2.GND3, U3.1 (A0), U3.2 (A1), U3.3 (A2), U3.4 (A3), U3.5 (A4), U3.14 (GND), U3.24 (A5), U3.25 (EXTCLK), U4.5 (GND), U4.6 (GND), U4.7 (GND), U4.8 (GND), U5.2 (GND), U5.4 (GND), U6.5 (GND), U6.6 (GND), U6.7 (GND), U6.8 (GND), WAKEUP.1, X1.1, X2.2, X2.15
IO0: JP6.6, PROG.1 (S), PROG.2 (S1), R1.2
LDR: LDR.2, R22.2, U1.3 (CH2+)
LED_G: R25.1, U3.22 (LED15)
LED_R: R23.1, U3.21 (LED14)
M1: MOT.1, U3.6 (LED0)
M2: MOT.3, U3.7 (LED1)
unnamed: Q1.1 (G), Q2.3 (D), R5.1
unnamed: C20.1, R3.2, R19.2, R24.1
unnamed: /OE.3, C8.1, LED_G.A, LED_R.A, OUTPUTS.2, U3.28 (VDD)
unnamed: CAN.2, U1.13 (CH4+)
unnamed: Q6.1 (G), Q7.3 (D), R6.1
unnamed: LED_R.C, R23.2
unnamed: LED_G.C, R25.2
unnamed: Q3.1 (G), Q8.3 (D), R17.1
unnamed: R8.2, X2.11
unnamed: M1.2, R21.1, U1.1 (CH1+)
unnamed: CAN.1, U1.14 (CH4-)
unnamed: S.1, U3.15 (LED8)
unnamed: S.2, U3.16 (LED9)
unnamed: S.3, U3.17 (LED10)
unnamed: S.4, U3.18 (LED11)
unnamed: S.5, U3.19 (LED12)
unnamed: S.6, U3.20 (LED13)
unnamed: R13.1, R14.2, U6.2 (ADJ)
unnamed: R15.1, R16.2, U4.2 (ADJ)
OE: /OE.2, U3.23 (/OE)
POWER: Q2.1 (G), Q8.1 (G), R12.1, U3.8 (LED2)
POWER_SD: Q7.1 (G), R7.1, U3.9 (LED3)
RST: C3.1, JP6.2, R2.1, RST.1 (S), RST.2 (S1), U2.EN
RX: JP6.5, U2.TXD0
SCL: I2C.2, U1.8 (SCL), U2.IO32, U3.26 (SCL)
SDA: I2C.3, U1.7 (SDA), U2.IO33, U3.27 (SDA)
SD_CLK: SD1.P$5 (CLK)
SD_D0: SD1.P$7 (DAT0), U2.IO2
SD_D2: SD1.P$1 (DAT2), U2.IO12
SD_D3: R26.2, SD1.P$2 (DAT3/CD), U2.IO13, WAKEUP.2
TX: JP6.4, U2.RXD0
V1_2.7V: C5.1, R15.2, U4.4 (OUT), X2.4
V2_1.8V: C6.1, C22.1, R13.2, U6.4 (OUT), X2.10
V+: C7.1, I2C.1, OUTPUTS.3, Q1.3 (D), R8.1, R9.1, R10.1, R21.2, R22.1, U1.6 (VDD), U4.1 (EN), U4.3 (IN), U6.1 (EN), U6.3 (IN)
V+_SD: Q6.3 (D), SD1.P$4 (VDD)
VCC: C1.1, C2.1, C14.1, C15.1, JP6.3, Q1.2 (S), Q6.2 (S), R1.1, R2.2, R5.2, R6.2, R26.1, U2.VDD33 (3V3), U5.3 (OUT)

Notes on the sheet:
If DTR is LOW, toggling RTS from HIGH to LOW resets to run mode. If RTS is HIGH, toggling DTR from LOW to HIGH resets to bootloader.
Boot Mode Configuration Pin Default Boot Download GPIO0 1 1 0 U0TXD 1 1 x GPIO2 0 x 0 GPIO4 0 x x MTDO 1 x x GPIO5 1 1 x If U0TXD, GPIO2, GPIO5 are floating, GPIO0 determines boot mode
V 4.0

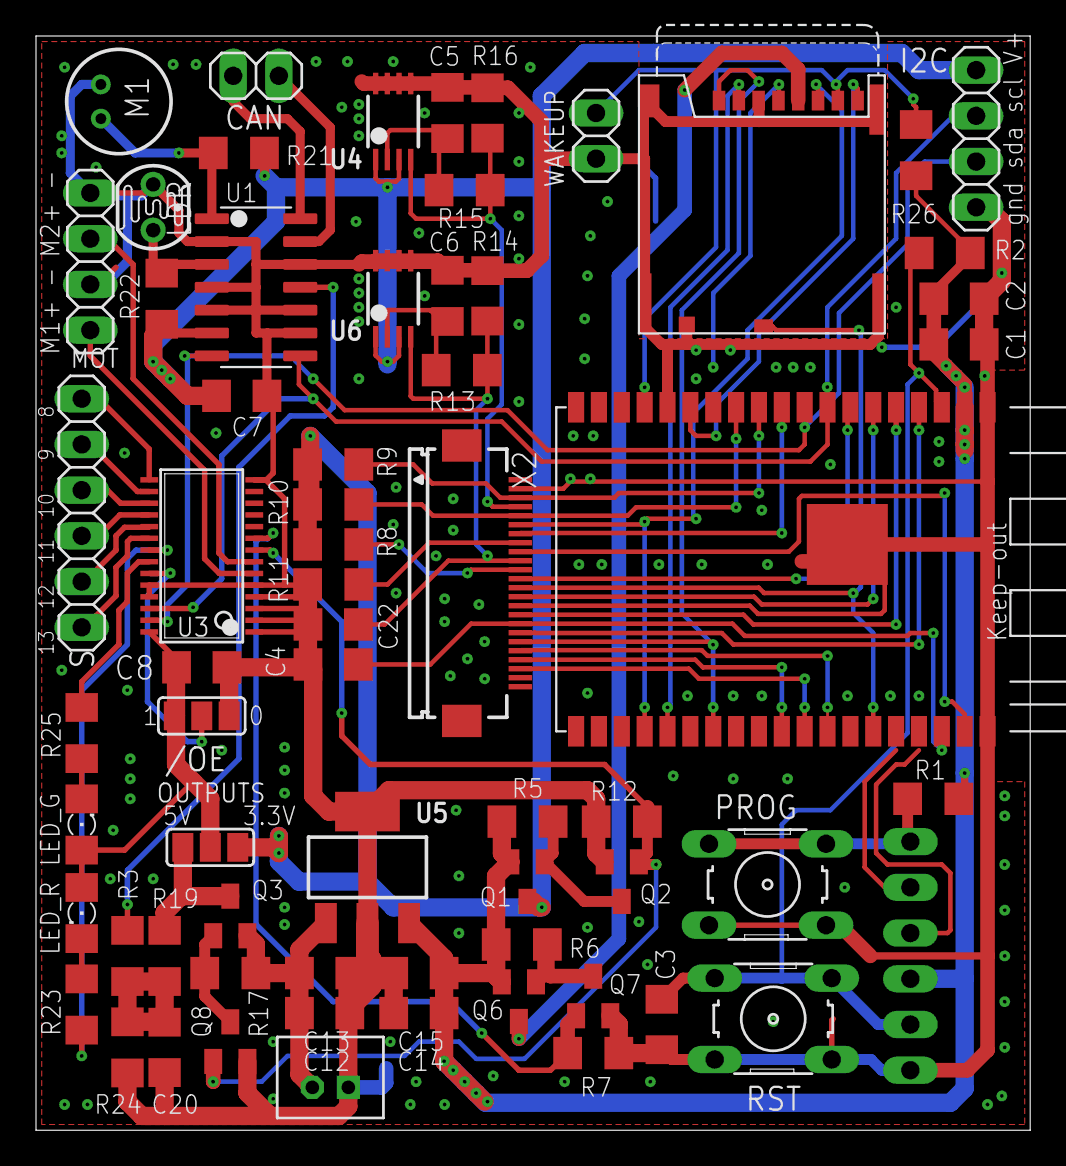
[picture p83: board ESP_CAM_VVN_v4.brd from above]

Board: 2 copper layers, 55.2 x 60.8 mm, 66 parts (1 on the bottom side), 61 nets.
