antopoid/Projet-frelons/(commit log)

2021-08-27 antoine - ancien projet
    [Projet_ruche_V1.0.kicad_pcb, Projet_ruche_V1.0.kicad_sch, Projet_ruche_V1.0.sch, calculateur_composant_buck.xlsx, trait_img.xlsm]
2021-08-27 romain - creation du fichier
    [Etat_des_lieux.xlsx]
2021-08-27 romain - mise a jour fichier roles
    [Etat_des_lieux.xlsx]
2021-09-22 Romain creation fichier
    [Rapport_detecteur_tonalite.xlsx]
2021-09-22 romain maj avec photos
    [Rapport_detecteur_tonalite.xlsx]
2021-09-23 Romain : creation fichier
    [Tableau_correspondance_pins.xlsx]
2021-09-23 Romain : maj
    [Tableau_correspondance_pins.xlsx]
2021-10-04 Romain maj fichier
    [Tableau_correspondance_pins.xlsx, Tableau_correspondance_pinsV2.xlsx]
2021-10-22 romain creation
    [ESP_CAM_VVN.brd, ESP_CAM_VVN.sch]
2021-10-22 gilbert ajout fichier wrover-cam
    [Tableau_correspondance_pinsV2.xlsx, wrover-cam.sch]
2021-10-22 gilbert maj
    [Tableau_correspondance_pinsV2.xlsx]
2021-10-22 romain maj schema
    [ESP_CAM_VVN.brd, ESP_CAM_VVN.sch, Tableau_correspondance_pinsV2.xlsx]
2021-11-02 romain maj
    [ESP_CAM_VVN.sch]
2021-12-10 antoine arduino test camera
2022-02-07 Rapport des seances du semestre par Gilbert Kagbadouno
2022-02-10 Mis a jour fait par Gilbert Kagbadouno
    [Tableau_correspondance_pinsV2.xlsx]
2022-02-11 antoine - ajout librairies
    [Arduino-Uno-r3-with-RFID-RC522.fzz]
2022-02-11 Mis a jour code esp32 cam
2022-03-04 antoine - add sd card arduino
2022-03-04 Mis à jour de la dernière séance
    [ESP_CAM_VVN_v4.brd, ESP_CAM_VVN_v4.sch, ESP_CAM_VVN_v5.brd, ESP_CAM_VVN_v5.sch]
2022-03-06 antoine - rapport de sceances mis a jour
2022-03-29 antoine MAj arduino MCP3428
2022-04-03 Mis à jour des rapports de séances
2022-04-03 antoine maj rapport de sceance
2022-05-19 antoine - update fichier peter
    [ESP_CAM_VVN_v5.brd, ESP_CAM_VVN_v5.sch]
