antopoid/Projet-frelons/(notices)

Notices in the files:
parts and their libraries:
micrel: Copyright (C) 2008, Bob Starr
